Tony9193/Morse_CH32V003/莫尔斯二叉树解码器_设计文档_V1.4.md

# 基于 CH32V003 的莫尔斯电码二叉树 LED 解析器
## Hardware Design Specification V1.4

| 项目 | 内容 |
|---|---|
| 文档版本 | V1.4（对照 2026-08-12 网表与原理图修订） |
| 日期 | 2026-08-12 |
| 用途 | 立创EDA 画板依据、BOM、软件设计说明、调试手册 |

> **V1.4 相对 V1.3 的变更：**
> 1. **LED 限流电阻位号统一改为 `R101~R137`**，彻底消解与 P1 页 `R32~R38` 的位号冲突。
> 2. **新增电源开关 `SW1`**（拨动开关，串联在 VBUS 线上），方便整机通断电。
> 3. **新增 KEY 按下指示灯 `RED1`**（+ R36 1kΩ），电键/按键按下时点亮，便于拍发反馈。
> 4. **器件封装调整**：3.5mm 耳机座改为贴片 `PJ-320D-1`；蜂鸣器改为贴片 `5V 电磁式`；按键改为 `6×6 SMD`。
> 5. **增加测试点**：`TP_5V`、`TP_GND`、`TP_VBUS`、`TP_UART_TX`、`TP_UART_RX` 等，方便调试验证。
> 6. **原理图连接修正**（对照网表确认）：`SER/SRCLK/RCLK/OE` 已正确连接；`U1.VDD` 已接 `+5V`（原疑似接地问题已修复）；LED 页已改用独立网络标签，巨型飞线已删除；595 级联链 `CAS1~CAS4` 已正确连接。
> 7. SWIO 烧录口合并到 H1 4P 排针（`+5V/GND/SWIO/NRST`），UART 调试口合并到 H2 2P 排针。
>
> **V1.3 相对 V1.2 的变更（仍然成立）：**
> 1. 字符集扩展为 **A–Z + 0–9**（树深 4→5 层，数字位于第 5 层）
> 2. 丝印布局由对称二叉树改为**经典莫尔斯点划树样式**
> 3. LED 31→**37 颗**（START + 26 字母 + 10 数字），74HC595 4→**5 片**
> 4. LED 位映射改为连续编址 + `NODE_TO_LED` 查表，固件 `led_state` 扩为 40bit
>
> **V1.2 相对 V1.1 的修正（仍然成立）：**
> 1. 取消 AMS1117，全板直接由 USB 5V 供电
> 2. LED 限流电阻改回 1kΩ（5V 下约 3mA）
> 3. 引脚分配与数据手册逐脚核对通过

---

# 1. 项目简介

## 1.1 项目名称

基于 RISC-V 单片机的莫尔斯电码解析与二叉树可视化显示系统

## 1.2 功能目标

- 支持板载按键输入与外接电键（3.5mm）输入，二者并联
- 自动识别点号 "·" 与划号 "−"
- 基于二叉树（堆编号）算法实时解析字符
- 每输入一个元素，LED 树对应节点点亮，直观展示"走树"过程
- 字符间隔后锁定字母，常亮显示并串口输出
- 支持 A–Z 26 个英文字母 + 0–9 10 个数字（5 层树，37 节点灯）
- 丝印采用经典莫尔斯点划树样式（点=圆、划=横条，左支为点、右支为划）
- 电位器实时调节点划判决速度，适应不同拍发手法
- USB-C 5V 供电，带硬件电源开关
- 预留第 5 层（数字/标点）子板扩展接口

## 1.3 设计约束

- 单板元件成本 ≤ 15 元
- PCB ≤ 100mm × 100mm，双层板
- 全部器件可手工焊接（无 BGA、无 QFN）

---

# 2. 系统总体框图

```
                 USB-C 5V ── SW1 ── 滤波 ── 全板 +5V
                    │        （CH32V003 支持 2.7~5.5V 直供）
        ┌───────────┼───────────────────┐
        │           │                   │
 电键 ──┤      ┌────┴─────┐       ┌─────┴──────┐
 (3.5mm)│      │ CH32V003 │  SPI  │ 74HC595 ×5 │
 板载按键├─KEY─▶│  F4P6    │──────▶│  级联 40bit │
 CLEAR ─┤      │          │       └─────┬──────┘
 电位器─┤ ADC  │          │             │ 37 路
 蜂鸣器◀┤ PWM  │  PD5/PD6 │       ┌─────┴──────┐
        │      │ UART TX/RX├─────▶│ 37×LED     │
        │      └────┬─────┘ 串口  │ 莫尔斯点划树│
        │           │ PD1        └────────────┘
        │      SWIO 烧录口
        └─ 扩展排针（595#5 QH′ 出 → 备用扩展）
```

---

# 3. 核心器件选型

| 模块 | 器件 | 封装 | 数量 | 说明 |
|---|---|---|---|---|
| MCU | CH32V003F4P6 | TSSOP-20 | 1 | RISC-V，16K Flash / 2K RAM，内部 HSI 免晶振 |
| LED 驱动 | 74HC595（SN74HC595DR） | SOP-16 | 5 | 级联 40 位移位寄存器，5V 供电 |
| LED | 0805 贴片高亮 | 0805 | 37 + 1 | D1~D37 为树节点；RED1 为 KEY 指示灯 |
| 输入按键 | 6×6 轻触开关 SMD | 贴片 | 2 | KEY(S1)、CLEAR(S2) |
| 电键接口 | 3.5mm 耳机座 PJ-320D-1 | 贴片 | 1 | 外接电键，贴片卧式 |
| 电源开关 | 拨动开关 SS-12D10L5 | 插件 | 1 | 串联在 VBUS 线上 |
| 调速 | 10kΩ 电位器（3296W/RV09） | 插件 | 1 | 点划判决基准时间 |
| 蜂鸣器 | 无源蜂鸣器 5V 电磁式 贴片 | SMD | 1 | 拍发侧音（可选） |
| 蜂鸣器驱动 | S8050 NPN | SOT-23 | 1 | GPIO 电流不足，三极管驱动 |
| 供电 | USB Type-C 母座 16P | 贴片 | 1 | 仅取电 |
| 烧录 | 4P 排针（5V/GND/SWIO/NRST） | 插件 | 1 | H1，WCH-LinkE（跳线选 5V 输出） |
| 调试 | 2P 排针（TX/RX） | 插件 | 1 | H2，接 USB 转串口模块 |
| 扩展 | 2×5P 排针 | 插件 | 1 | J4，备用扩展接口 |
| 测试点 | 0.5mm 焊盘 | — | 8 | TP_5V、TP_GND、TP_VBUS、TP_UART_TX、TP_UART_RX 等 |

---

# 4. MCU 引脚分配

**CH32V003F4P6（TSSOP-20）可用 GPIO：PA1、PA2、PC0~PC7、PD0~PD7。**
没有 PA3~PA7，没有 Port B。SWIO 固定为 PD1，不可复用。

| 功能 | 引脚 | 说明 |
|---|---|---|
| KEY（电键 + 板载按键并联） | PA1 | 内部上拉，接地为按下 |
| CLEAR 功能键 | PA2 | 内部上拉；短按回根，长按切换显示模式 |
| 速度调节电位器 ADC | PC4 | 合法 ADC 通道（CH2） |
| 595 DATA（SER） | PC0 | |
| 595 CLOCK（SRCLK） | PC1 | |
| 595 LATCH（RCLK） | PC2 | |
| 595 OE | PC3 | 接地则常亮；接 GPIO 可 PWM 整体调光/闪烁 |
| 蜂鸣器（TIM1_CH1N PWM） | PD0 | 经 S8050 驱动蜂鸣器 |
| **SWIO 烧录口** | **PD1** | **固定功能脚，禁止复用** |
| UART TX | PD5 | 解码字符输出 / printf 调试 |
| UART RX | PD6 | 预留（上位机命令） |
| 备用 | PC5/PC6/PC7、PD2/PD3/PD4 | 引至扩展排针 J4 |
| NRST | PD7 | 复位脚，不作 IO；引至 H1 排针 |

---

# 5. 电源设计

## 5.1 5V 直供（V1.2 简化，V1.4 增加开关）

数据手册 1.4.3 节：VDD = 2.7~5.5V，CH32V003 支持 5V 直供。
不需要 LDO：USB 5V 经 SW1 开关后给全板供电。

```
USB VBUS ── SW1 ──┬──────── +5V（全板：MCU VDD + 595 VCC + LED）
                  │
               10µF ┴ 100nF ┴（入口滤波，靠近座子）
                  │
USB GND ──────────┴──────── GND

CC1 ── 5.1kΩ ── GND
CC2 ── 5.1kΩ ── GND     ← 必须！否则 PD 充电头不输出 5V
```

## 5.2 去耦

- MCU：VDD（9 脚）就近 100nF（C3）到 VSS（7 脚）
- 每片 595：VCC 就近 100nF（C4~C8）到地
- 所有 VSS 就近过孔回地平面

---

# 6. 莫尔斯输入模块

## 6.1 板载按键 + 外接电键（并联，共用 PA1）

```
+5V ── R38(1kΩ 硬上拉) ──┬──── PA1 ──── 板载 KEY(S1) ── GND
                          │
                          └── R32(1kΩ) ── CN1 TIP（电键）
                                            CN1 SLEEVE ── GND
                                            CN1 RING ── 与 TIP 并接
```

- 默认高电平，按下/电键闭合为低
- **R38 外部硬上拉保留**：电键线缆长时抗干扰远好于 MCU 内部 ~40k 上拉
- **KEY 指示灯**：+5V → RED1 阳极 → RED1 阴极 → R36(1kΩ) → KEY 节点，按下时点亮
- **不加硬件消抖电容**：电键快速拍发时电容会吃掉短点，消抖全部由软件完成（15ms）
- R32 串联电阻仅作外部接口 ESD/浪涌保护
- RING 与 TIP 并接：兼容单声道(TS)/立体声(TRS)两种插头的电键

## 6.2 CLEAR 功能键（PA2）

- 短按：清空树、回到根节点
- 长按（>1s）：切换显示模式（单点模式 ↔ 路径模式）

## 6.3 速度调节电位器（PC4 / ADC）

- 10kΩ 电位器两端接 5V 与 GND，中间抽头接 PC4（ADC 输入范围 0~VDD，满量程利用）
- ADC 采样值线性映射基准时间 T：60ms ~ 300ms
- 覆盖约 5~20 WPM 的手键速度范围

---

# 7. 莫尔斯识别算法

## 7.1 时间定义（T 由电位器设定）

| 元素 | 标准时长 | 判决门限 |
|---|---|---|
| 点 "·" | T | 按下时间 < 2T |
| 划 "−" | 3T | 按下时间 ≥ 2T |
| 字符间隔 | 3T | 松开 ≥ 2.5T → 锁定当前节点为字母 |
| 单词间隔 | 7T | 松开 ≥ 6T → 输出空格，树复位 |
| 消抖 | — | 15ms |

## 7.2 二叉树节点编号（堆编号）

- 根节点 START = 1
- 点（左子）：node = node × 2
- 划（右子）：node = node × 2 + 1
- node > 63：超出 5 层 → 全树闪烁报错 → 回根
- 第 1~4 层为字母区，第 5 层（node 32~63）仅 10 个数字有定义，其余为未分配码

## 7.3 节点 → 字符查表（软件常量）

```
字母区（node 1~29，node 19/21/30/31 为 Ü/Ä/空码，不定义、不装灯）：
index:  1    2   3   4   5   6   7   8   9  10  11  12  13  14  15
char:  START  E   T   I   A   N   M   S   U   R   W   D   K   G   O
index: 16  17  18   19   20  21   22  23  24  25  26  27  28  29
char:  H   V   F  [Ü]  L  [Ä]  P   J   B   X   C   Y   Z   Q

数字区（node 32~63，仅下列 10 个有定义）：
node:  32   33   35   39   47   48   56   60   62   63
char:  5    4    3    2    1    6    7    8    9    0
morse: ..... ....- ...-- ..--- .---- -.... --... ---.. ----. -----
```

C 语言查表（索引 0 不用，未定义 = '?'）：

```c
const char MORSE_CHAR[64] = {
    ' ',                                                // 0 占位
    ' ',                                                // 1 START
    'E','T','I','A','N','M',                            // 2-7
    'S','U','R','W','D','K','G','O',                    // 8-15
    'H','V','F','?','L','?','P','J',                    // 16-23 (19=Ü,21=Ä)
    'B','X','C','Y','Z','Q','?','?',                    // 24-31
    '5','4','?','3','?','?','?','2',                    // 32-39
    '?','?','?','?','?','?','?','1',                    // 40-47
    '6','?','?','?','?','?','?','?',                    // 48-55
    '7','?','?','?','8','?','9','0'                     // 56-63
};
```

## 7.4 示例

输入 ".-."：
START(node=1) → "·" node=2(E) → "−" node=5(A) → "·" node=10(R)
松开超过 2.5T → 锁定 node 10 → 点亮 R → UART 输出 'R'

---

# 8. LED 显示模块

## 8.1 74HC595 级联

```
            PC0(SER)      QH′         QH′         QH′         QH′
MCU ───────▶ 595#1 ──────▶ 595#2 ─────▶ 595#3 ─────▶ 595#4 ─────▶ 595#5 ──QH′──▶ 扩展排针
              (链首)                                                   (链尾)
全部并联：PC1 → SRCLK(11脚) ×5；PC2 → RCLK(12脚) ×5；PC3 → OE(13脚) ×5
SRCLR(10脚) ×5 → +5V（不清零，恒有效）
```

## 8.2 LED 编址与移位方向（软硬件契约，务必一致）

由于数字节点在堆编号中不连续（32~63 里只有 10 个有定义），**LED 改用连续序号编址**：
- LED 序号 i = 0~36（共 37 颗），位号 D(i+1)，位映射见 8.3 表
- 固件维护 `uint64_t led_state`（只用低 40 bit），**bit i = 1 表示 LED i 亮**
- 节点号 → LED 序号由 `NODE_TO_LED[64]` 查表转换（无定义节点 = -1）
- 发送顺序：**bit39 先发，bit0 最后**；结果 bit0 落在 595#1 的 QA

```c
// 节点号 → LED 序号（-1 = 该节点无灯）
const int8_t NODE_TO_LED[64] = {
    -1,                                                 // 0
     0,  1,  2,  3,  4,  5,  6,                          // 1-7
     7,  8,  9, 10, 11, 12, 13, 14,                     // 8-15
    15, 16, 17, -1, 18, -1, 19, 20,                     // 16-23
    21, 22, 23, 24, 25, 26, -1, -1,                     // 24-31
    27, 28, -1, 29, -1, -1, -1, 30,                     // 32-39
    -1, -1, -1, -1, -1, -1, -1, 31,                     // 40-47
    32, -1, -1, -1, -1, -1, -1, -1,                     // 48-55
    33, -1, -1, 34, -1, 35, 36                          // 56-63
};
```

## 8.3 LED 映射表（37 灯，V1.4 电阻位号更新为 R101~R137）

| 595 | QA | QB | QC | QD | QE | QF | QG | QH |
|---|---|---|---|---|---|---|---|---|
| #1 (bit0-7) | D1 START<br>R101 | D2 E<br>R102 | D3 T<br>R103 | D4 I<br>R104 | D5 A<br>R105 | D6 N<br>R106 | D7 M<br>R107 | D8 S<br>R108 |
| #2 (bit8-15) | D9 U<br>R109 | D10 R<br>R110 | D11 W<br>R111 | D12 D<br>R112 | D13 K<br>R113 | D14 G<br>R114 | D15 O<br>R115 | D16 H<br>R116 |
| #3 (bit16-23) | D17 V<br>R117 | D18 F<br>R118 | D19 L<br>R119 | D20 P<br>R120 | D21 J<br>R121 | D22 B<br>R122 | D23 X<br>R123 | D24 C<br>R124 |
| #4 (bit24-31) | D25 Y<br>R125 | D26 Z<br>R126 | D27 Q<br>R127 | D28 "5"<br>R128 | D29 "4"<br>R129 | D30 "3"<br>R130 | D31 "2"<br>R131 | D32 "1"<br>R132 |
| #5 (bit32-39) | D33 "6"<br>R133 | D34 "7"<br>R134 | D35 "8"<br>R135 | D36 "9"<br>R136 | D37 "0"<br>R137 | NC | NC | NC |

> 丝印在每个 LED 旁标注字符（如 `R`、`5`）；节点号仅供固件调试对照（UART printf 用）。

## 8.4 单路 LED 驱动

```
595 Qx ── R10n(1kΩ) ──▶|── GND
               LED（共阴）
```

- 5V 系统：If ≈ (5−2.0)/1k ≈ 3mA，高亮 0805 LED 足够亮；想更亮可换 680Ω（约 4.4mA）
- 单芯片最大同时点亮 8 路 × 3mA = 24mA < 74HC595 单芯片 70mA 限额，安全
- 路径模式最多 5 灯同亮（根+4 层），电流无忧

## 8.5 显示模式

| 模式 | 行为 |
|---|---|
| 单点模式（默认） | 只有当前节点亮，直观展示"走树" |
| 路径模式 | 从 START 到当前节点整条路径点亮，教学演示用 |
| 锁定态 | 字母判定后该节点常亮 1.5s（或闪烁 3 次），UART 输出字符，随后回根 |

---

# 9. UART 输出

- PD5(TX)/PD6(RX)，115200 8N1
- 字符锁定时输出该字母；单词间隔输出空格
- 调试期兼作 printf（拍发时长、T 值、node 值均可打印）
- 可直接接 USB 转串口在电脑上实时看解码文本

---

# 10. PCB 布局布线规范

## 10.1 基本参数

- 尺寸：100mm × 100mm，双层板，1.6mm，白油黑字（或其他）
- 元件面：LED 树全部在**正面**（正面即面板）；MCU/595/电源全部在**背面**

## 10.2 正面布局（经典点划树样式，与参考图一致）

```
                         摩尔斯码
                        ★ START
   5   H   S   I   E    │    T   M   O   0     ← 顶部主干（点链向左下，划链向右上）
   ·   ·   ·   ·   ·    ★    −   −   −   −
       4   V       U         G   Q   9
       ·   ·       ·         ·   −   ·
       3   F       R         Z   7   8
       −   ·   L   ·   N     ·   ·   ·
       2       P   A   ·   K         Y
       −       ·   −   D   −         −
           L       J   ·   X   C     B
           ·       −   ·   −   ·     ·
                       1           6
                       −           ·
```

- **丝印即说明书**：点划符号画在每个节点 LED 旁边，从 START 出发沿"点左划右"即可读出任意字符的编码，无需查表
- LED 放在每个字符节点处；布局为非对称紧凑式，宽约 9 列 × 高约 8 行，100×100mm 板轻松容纳
- 顶部留"摩尔斯码"标题丝印；START 可用星形丝印 + 不同颜色 LED 突出
- 底部/侧边空白区放：USB-C（板边）、电键 3.5mm 座（板边）、KEY/CLEAR 按键、电位器、烧录焊盘、扩展排针

## 10.3 背面布局与布线

- 595#1~#4 就近放在其所驱动层级的背面投影区，缩短 LED 走线
- 级联链注意顺序：PC0 → 595#1 SER；#1 QH′ → #2 SER；…；#4 QH′ → 扩展排针
- LED 阴极统一就近过孔回地平面
- 底层整面铺铜 GND；顶层空白区铺铜 GND 并打缝合过孔
- 5V 走线 ≥ 20mil；信号线 ≥ 10mil
- SWIO 烧录排针 H1 放板边，丝印标注 5V/GND/SWIO/NRST（WCH-LinkE 跳线选 5V 档）

---

# 11. 立创EDA 封装选择表

| 器件 | 立创商城参考型号 | 封装 |
|---|---|---|
| CH32V003F4P6 | C2913202 类（搜 CH32V003F4P6） | TSSOP-20 |
| 74HC595 | SN74HC595DR | SOP-16 |
| USB-C 16P 母座 | TYPE-C-31-M-12（C165948） | 贴片+定位柱 |
| 3.5mm 耳机座 | PJ-320D-1 | 贴片卧式 |
| 轻触按键 | 6×6 SMD 类 | 贴片 |
| 电位器 | 3296W-103 或 RV09 10k | 插件 |
| 无源蜂鸣器 5V | 贴片电磁式 5.0×5.5mm | 贴片 |
| LED | 0805 贴片高亮 | 0805 |
| 电阻/电容 | 0805 常规 | 0805 |
| 电解电容 | 10µF/16V 贴片 | 贴片 |

---

# 12. BOM 预算

| 器件 | 数量 | 参考单价 | 小计 |
|---|---|---|---|
| CH32V003F4P6 | 1 | 1.5 元 | 1.5 元 |
| 74HC595 SOP-16 | 5 | 0.5 元 | 2.5 元 |
| 0805 LED | 38 | 0.05~0.1 元 | 2~3.5 元 |
| 电阻（1kΩ×42、5.1kΩ×2） | 一批 | — | ~0.6 元 |
| 电容（100nF×7、10µF×1） | 一批 | — | 0.3 元 |
| S8050 三极管 | 1 | 0.05 元 | 0.05 元 |
| USB-C 母座 | 1 | 0.5 元 | 0.5 元 |
| 3.5mm 耳机座 PJ-320D-1 | 1 | 0.5 元 | 0.5 元 |
| 轻触按键 SMD | 2 | 0.1 元 | 0.2 元 |
| 拨动开关 SS-12D10L5 | 1 | 0.3 元 | 0.3 元 |
| 10k 电位器 | 1 | 0.5 元 | 0.5 元 |
| 无源蜂鸣器 5V 贴片 | 1 | 0.8 元 | 0.8 元 |
| 排针/扩展座 | 一批 | — | 0.5 元 |
| **元件合计** | | | **≈10~11 元** |
| PCB 100×100 双层（5 片） | — | — | 20~30 元（JLC 用券可更低） |
| WCH-LinkE 下载器（一次性） | 1 | — | 15~20 元 |

**首批总投入 ≈ 40~50 元；摊到单板元件成本 ≈ 10 元。**

---

# 13. 软件设计

## 13.1 总体结构

```
初始化：GPIO / SysTick(1ms) / ADC(PC4) / UART(115200) / OE 使能
主循环：
  ├─ 每 1ms：按键消抖状态机（15ms 确认）
  ├─ 按下沿：记录 t_down；蜂鸣器侧音开
  ├─ 松开沿：时长 = now − t_down
  │     < 2T → 点：node = node*2
  │     ≥ 2T → 划：node = node*2+1
  │     node > 63 → 报错闪烁 → node=1
  │     查 NODE_TO_LED[node]，更新 led_state → 刷新 595
  ├─ 松开持续 ≥ 2.5T 且 node≠1 → 锁定：
  │     字符 = MORSE_CHAR[node]，常亮/闪烁，UART 输出，回根
  │     （若 MORSE_CHAR[node]=='?' → 无效码，报错闪烁，回根）
  ├─ 松开持续 ≥ 6T → UART 输出空格
  ├─ 每 100ms：ADC 采样电位器 → T = 60ms + adc/4095 × 240ms
  └─ CLEAR：短按回根；长按切换单点/路径模式
```

## 13.2 核心函数契约

```c
void shift595(uint64_t bits);      // bit39 先发，bit0 最后；bit i = LED i
void led_set_node(uint8_t node);   // 单点模式：led = NODE_TO_LED[node]
void led_set_path(uint8_t node);   // 路径模式：逐位回溯父节点 node/2（跳过无灯节点）
void led_error_blink(void);        // 全树闪烁 3 次
uint16_t adc_read_T(void);         // 电位器 → 基准时间 T(ms)
```

## 13.3 刷新 595（位序关键代码）

```c
void shift595(uint64_t bits) {
    for (int i = 39; i >= 0; i--) {          // 40bit：bit39 先发
        GPIO_Write(SER, (bits >> i) & 1);
        GPIO_Write(SRCLK, 1); GPIO_Write(SRCLK, 0);
    }
    GPIO_Write(RCLK, 1); GPIO_Write(RCLK, 0); // 锁存
}
```

---

# 14. 调试流程（Bring-up）

| 步骤 | 操作 | 判据 |
|---|---|---|
| 1 | 不上电目检：短路、虚焊、方向（LED/电解/芯片 1 脚） | 无异常 |
| 2 | 焊 MCU 之前先上电，测 5V 网络 | 5V ±5% |
| 3 | 插 MCU，接 WCH-LinkE 烧录流水灯固件 | 37 灯按 LED 序号依次点亮 → 验证 595 链路与映射表 |
| 4 | 按键测试：按下/松开时 UART 打印时长 | 时长正确、无抖动误触发；RED1 同步亮灭 |
| 5 | 点划判决：电位器居中，拍发 "·−·" | node 走到 10，锁定输出 'R' |
| 6 | SOS 测试："··· −−− ···" | UART 输出 "SOS"，树路径正确 |
| 7 | 全表遍历：A–Z、0–9 逐个拍发 | 全部正确锁定（数字需拍满 5 元素） |
| 8 | 电位器两端极限各重测步骤 6 | 快慢手法均可解码 |

---

# 15. 扩展规划

## 15.1 扩展接口（备用）

V1.3 起数字 0–9 已并入主板，扩展排针改为备用：5V、GND、SER-OUT（595#5 QH′）、OE、6 路备用 IO。
可用于：第 6 层标点符号子板（. , ? / = 等位于 node 64~127 区段）、外接大尺寸LED墙、或级联第二块同款板。

## 15.2 V2 软件功能

- 自适应速度（以最近若干点的平均时长自动校准 T）
- 练习模式：蜂鸣器随机播放字母 → 用户拍发 → 树验证对错（CW 练习器）
- 解码文本通过 UART 连续输出，接电脑成"莫尔斯→文本"转换器

---

# 16. 逐网络连接清单（位号 / Netlist）

本章是画原理图的唯一依据，所有连接已按两本数据手册逐脚核对。
网络名约定：`+5V`、`GND` 为电源；其余按功能命名。

## 16.1 位号总表

| 位号 | 器件 | 位号 | 器件 |
|---|---|---|---|
| U1 | CH32V003F4P6（TSSOP-20） | Q1 | S8050（SOT-23） |
| U2 | 74HC595 #1（LED 0~7） | BZ1 | 无源蜂鸣器 5V 贴片 |
| U3 | 74HC595 #2（LED 8~15） | RP1 | 10kΩ 电位器 |
| U4 | 74HC595 #3（LED 16~23） | S1 | KEY 轻触按键 |
| U5 | 74HC595 #4（LED 24~31） | S2 | CLEAR 轻触按键 |
| U6 | 74HC595 #5（LED 32~36，余 3 路空） | SW1 | 拨动开关（电源） |
| D1~D37 | LED（D1=START，对应 LED 序号 0~36） | CN1 | 3.5mm 耳机座 PJ-320D-1 |
| RED1 | KEY 指示灯 LED | J4 | 2×5P 扩展排针 |
| R101~R137 | LED 限流 1kΩ（R10n 对应 Dn） | H1 | 4P 排针（+5V/GND/SWIO/NRST） |
| R32 | 电键串联保护 1kΩ | H2 | 2P 排针（UART TX/RX） |
| R38 | KEY 外部硬上拉 1kΩ | C1 | 10µF 电解（USB 入口） |
| R33 | Q1 基极电阻 1kΩ | C2 | 100nF（USB 入口） |
| R34/R35 | CC1/CC2 下拉 5.1kΩ | C3 | 100nF（U1 VDD 去耦） |
| R36 | RED1 限流 1kΩ | C4~C8 | 100nF（U2~U6 去耦） |
| — | TP_5V、TP_GND、TP_VBUS、TP_UART_TX、TP_UART_RX 等测试点 | — | — |

## 16.2 U1（CH32V003F4P6）逐脚连接

| 脚 | 片上功能 | 连接网络 | 去向 |
|---|---|---|---|
| 1 | PD4 | SPARE_PD4 | J4-9 |
| 2 | PD5/UTX | UART_TX | H2-1 / TP_UART_TX |
| 3 | PD6/URX | UART_RX | H2-2 / TP_UART_RX |
| 4 | PD7/NRST | NRST | H1-4 |
| 5 | PA1 | KEY | S1 一端 + R32 一端 + RED1 阴极（经 R36） |
| 6 | PA2 | CLEAR | S2 一端 |
| 7 | VSS | GND | 地平面 |
| 8 | PD0 | TONE | R33 → Q1 基极 |
| 9 | VDD | +5V | C3 去耦到地 |
| 10 | PC0 | SER | U2-14 |
| 11 | PC1 | SRCLK | U2/U3/U4/U5/U6-11（并联） |
| 12 | PC2 | RCLK | U2/U3/U4/U5/U6-12（并联） |
| 13 | PC3 | OE | U2/U3/U4/U5/U6-13（并联） |
| 14 | PC4/A2 | SPEED_ADC | RP1 中间抽头 |
| 15 | PC5 | SPARE_PC5 | J4-7 |
| 16 | PC6 | SPARE_PC6 | J4-8 |
| 17 | PC7 | SPARE_PC7 | J4-10 |
| 18 | PD1/SWIO | SWIO | H1-3 |
| 19 | PD2 | SPARE_PD2 | J4-5 |
| 20 | PD3 | SPARE_PD3 | J4-6 |

## 16.3 U2~U6（74HC595）公共连接

| 脚 | 名称 | 连接 |
|---|---|---|
| 16 | VCC | +5V（每片就近 C4~C8 100nF 去耦） |
| 8 | GND | GND |
| 14 | SER | U2: PC0/SER；U3: U2-9(QH′)；U4: U3-9(QH′)；U5: U4-9(QH′)；U6: U5-9(QH′) |
| 11 | SRCLK | PC1（五片并联） |
| 12 | RCLK | PC2（五片并联） |
| 13 | OE | PC3（五片并联，低有效） |
| 10 | SRCLR | +5V（五片并联，不清零） |
| 9 | QH′ | 级联至下一片 SER；U6-9 → J4-3（扩展输出） |

## 16.4 U2~U6 输出与 LED（R10n = 1kΩ，Dn 阴极接地）

| 输出脚位 | U2 | U3 | U4 | U5 | U6 |
|---|---|---|---|---|---|
| QA（15脚） | R101→D1（START） | R109→D9（U） | R117→D17（V） | R125→D25（Y） | R133→D33（6） |
| QB（1脚） | R102→D2（E） | R110→D10（R） | R118→D18（F） | R126→D26（Z） | R134→D34（7） |
| QC（2脚） | R103→D3（T） | R111→D11（W） | R119→D19（L） | R127→D27（Q） | R135→D35（8） |
| QD（3脚） | R104→D4（I） | R112→D12（D） | R120→D20（P） | R128→D28（5） | R136→D36（9） |
| QE（4脚） | R105→D5（A） | R113→D13（K） | R121→D21（J） | R129→D29（4） | R137→D37（0） |
| QF（5脚） | R106→D6（N） | R114→D14（G） | R122→D22（B） | R130→D30（3） | 空 NC |
| QG（6脚） | R107→D7（M） | R115→D15（O） | R123→D23（X） | R131→D31（2） | 空 NC |
| QH（7脚） | R108→D8（S） | R116→D16（H） | R124→D24（C） | R132→D32（1） | 空 NC |

连接关系：`595 Qx ── R10n(1kΩ) ── Dn 阳极；Dn 阴极 ── GND`

## 16.5 输入/外设电路

**按键与电键：**
```
+5V ── R38(1kΩ) ──┬── U1-5 (KEY) ── S1 ── GND
                  ├── RED1 阳极 ── RED1 阴极 ── R36(1kΩ) ── KEY 节点
                  └── R32(1kΩ) ── CN1 TIP
                                   CN1 SLEEVE ── GND
                                   CN1 RING ── 与 TIP 并接
U1-6 (CLEAR) ── S2 ── GND（CLEAR 用内部上拉即可）
```
（KEY 加外部 1kΩ 硬上拉抗长线干扰；RED1 作按下指示灯；均不接消抖电容）

**速度电位器：**
```
RP1 一端 ── +5V；RP1 另一端 ── GND；RP1 中间抽头 ── U1-14 (SPEED_ADC)
```

**蜂鸣器驱动：**
```
U1-8 (TONE) ── R33(1kΩ) ── Q1 基极
Q1 发射极 ── GND；Q1 集电极 ── BZ1(−)
BZ1(+) ── +5V
```

**USB-C 取电：**
```
J1 VBUS(A4/B4/A9/B9 并接) ── SW1 ── +5V ── C1(10µF) + C2(100nF) ── GND
J1 GND(A1/B1/A12/B12 并接) ── GND
J1 CC1(A5) ── R34(5.1kΩ) ── GND
J1 CC2(B5) ── R35(5.1kΩ) ── GND
J1 D+/D− ── 悬空
```

## 16.6 连接器针脚定义

**H1（4P 排针，烧录 + 复位）：** 1=+5V，2=GND，3=SWIO（U1-18），4=NRST（U1-4）。WCH-LinkE 跳线选 5V 档。

**H2（2P 排针，UART 调试）：** 1=UART_TX（U1-2），2=UART_RX（U1-3）。可接 USB 转 TTL 模块。

**J4（扩展排针，2×5P）：**

| 针 | 信号 | 针 | 信号 |
|---|---|---|---|
| 1 | +5V | 2 | GND |
| 3 | SER-OUT（U6-9 QH′） | 4 | OE |
| 5 | SPARE_PD2 | 6 | SPARE_PD3 |
| 7 | SPARE_PC5 | 8 | SPARE_PC6 |
| 9 | SPARE_PD4 | 10 | SPARE_PC7 |

## 16.7 已核对项清单

- [x] CH32V003F4P6 引脚存在性（数据手册第 2 章 TSSOP20 全图）
- [x] SWIO = PD1（18 脚），不可复用
- [x] PC4 = ADC 通道 A2（14 脚）；PD5/PD6 = USART 默认 TX/RX
- [x] VDD = 2.7~5.5V，支持 5V 直供（1.4.3 节）
- [x] 74HC595 引脚定义（QA=15, QB~QH=1~7, QH′=9, SRCLR=10, SRCLK=11, RCLK=12, OE=13, SER=14, VCC=16, GND=8）
- [x] 74HC595 VCC 2~6V；VIH@5V ≈ 3.5V < MCU 5V 输出高电平，裕量充足
- [x] 74HC595 单路推荐 ±6mA / 单芯片 ±70mA vs 本设计 3mA×8 = 24mA，安全
- [x] OE/SRCLR 均为低有效，接法正确（OE 由 GPIO 控制，SRCLR 接高）
- [x] 全板 LED 同时点亮（自检模式）总电流 37×3mA ≈ 111mA，USB 5V 供电无压力
- [x] USB-C CC 下拉 5.1kΩ ×2，PD 充电头可正常输出 5V
- [x] 网表验证：SER/SRCLK/RCLK/OE 各网络连通正确，无短路
- [x] 网表验证：LED0~LED36 每路独立，无飞线短接
- [x] 网表验证：595 级联链 CAS1~CAS4 正确
- [x] 网表验证：U1.VDD 接 +5V（C3 一端 +5V 一端 GND，去耦正确）

---

# END
