Tony9193/Morse_CH32V003/SCH_Schematic1_2026-08-12.pdf

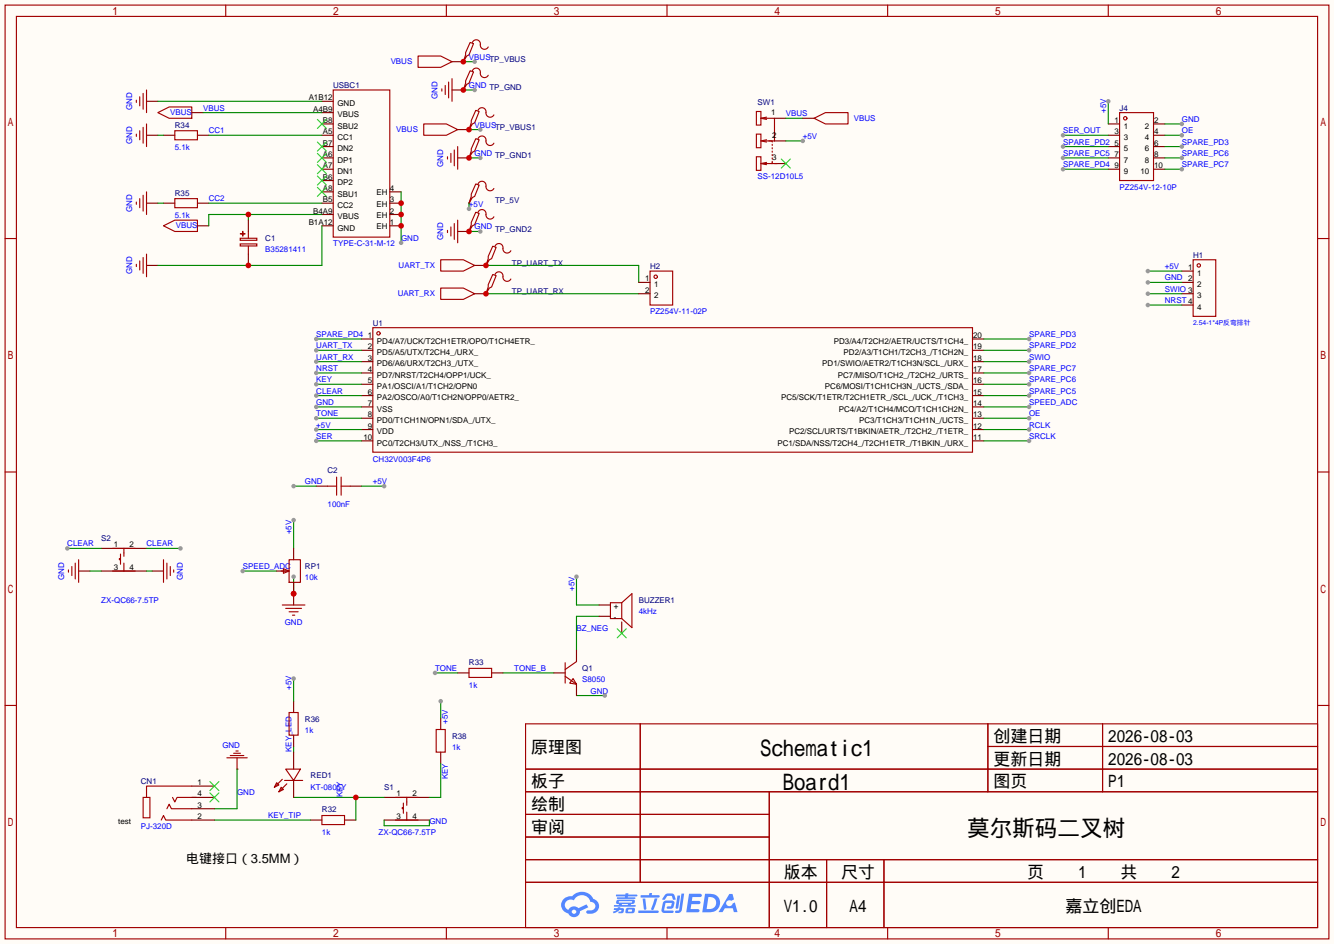
[picture p1: page 1]

原理图 | Schematic1 | 创建日期 | 2026-08-03

更新日期 | 2026-08-03

板子 | Board1 | 图页 | P1
绘制 | | 莫尔斯码二叉树
审阅

V1.0 | A4 | 嘉立创EDA

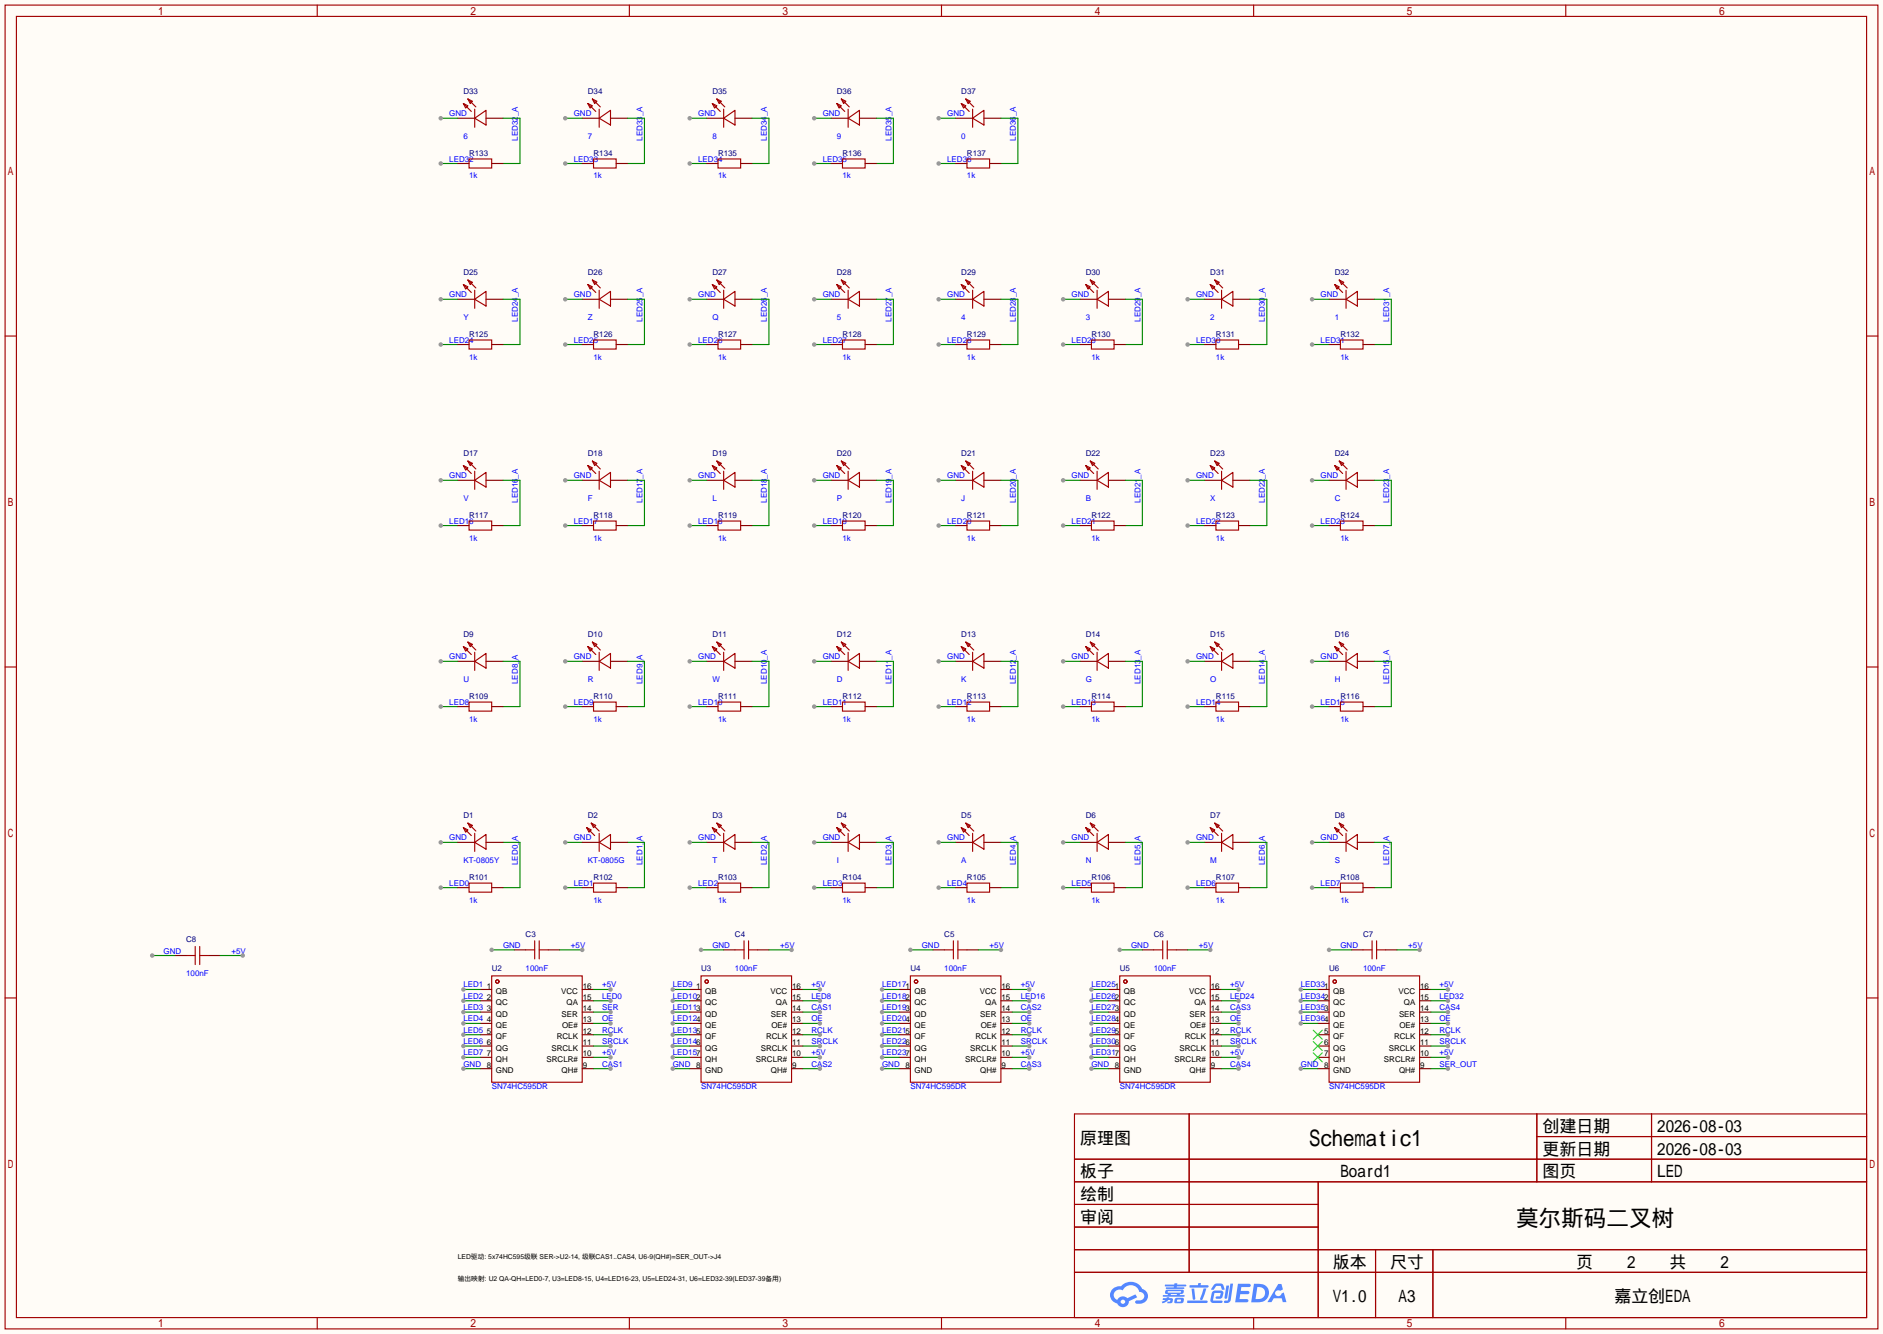
[picture p2: page 2]

原理图 | Schematic1 | 创建日期 | 2026-08-03

更新日期 | 2026-08-03

板子 | Board1 | 图页 | LED
绘制 | | 莫尔斯码二叉树
审阅

V1.0 | A3 | 嘉立创EDA
