Tony9193/Morse_CH32V003/(commit log)

2026-08-12 初始提交：莫尔斯二叉树解码器（CH32V003）固件与设计文档
2026-08-12 添加仓库根目录 README
2026-08-12 同步预构建固件（NORMAL/VOL0/VOL20/BRINGUP）并更新 README 与烧录说明
